FateNozomi/shichi-pcb/shichi.gerber/drill_config.png

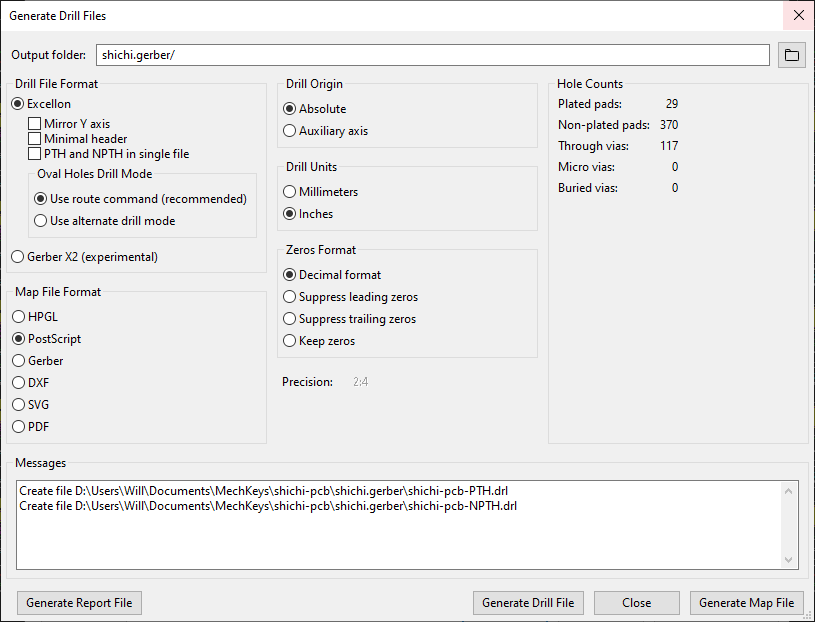
shichi.gerber/drill_config.png
