FateNozomi/shichi-pcb/shichi.gerber/plot_config.png

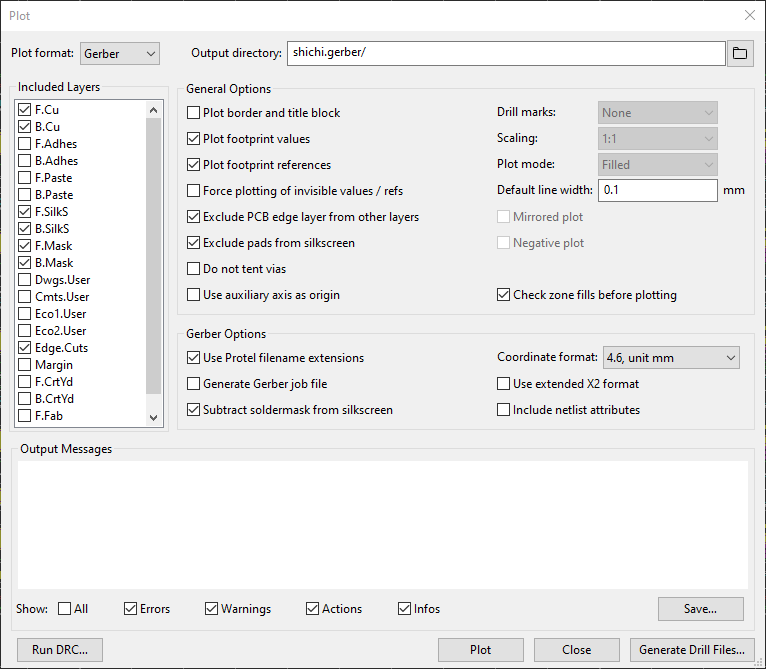
shichi.gerber/plot_config.png
