FateNozomi/shichi-pcb/shichi-pcb.kicad_pcb

## KiCad design shichi-pcb.kicad_pcb (2019-11-03)

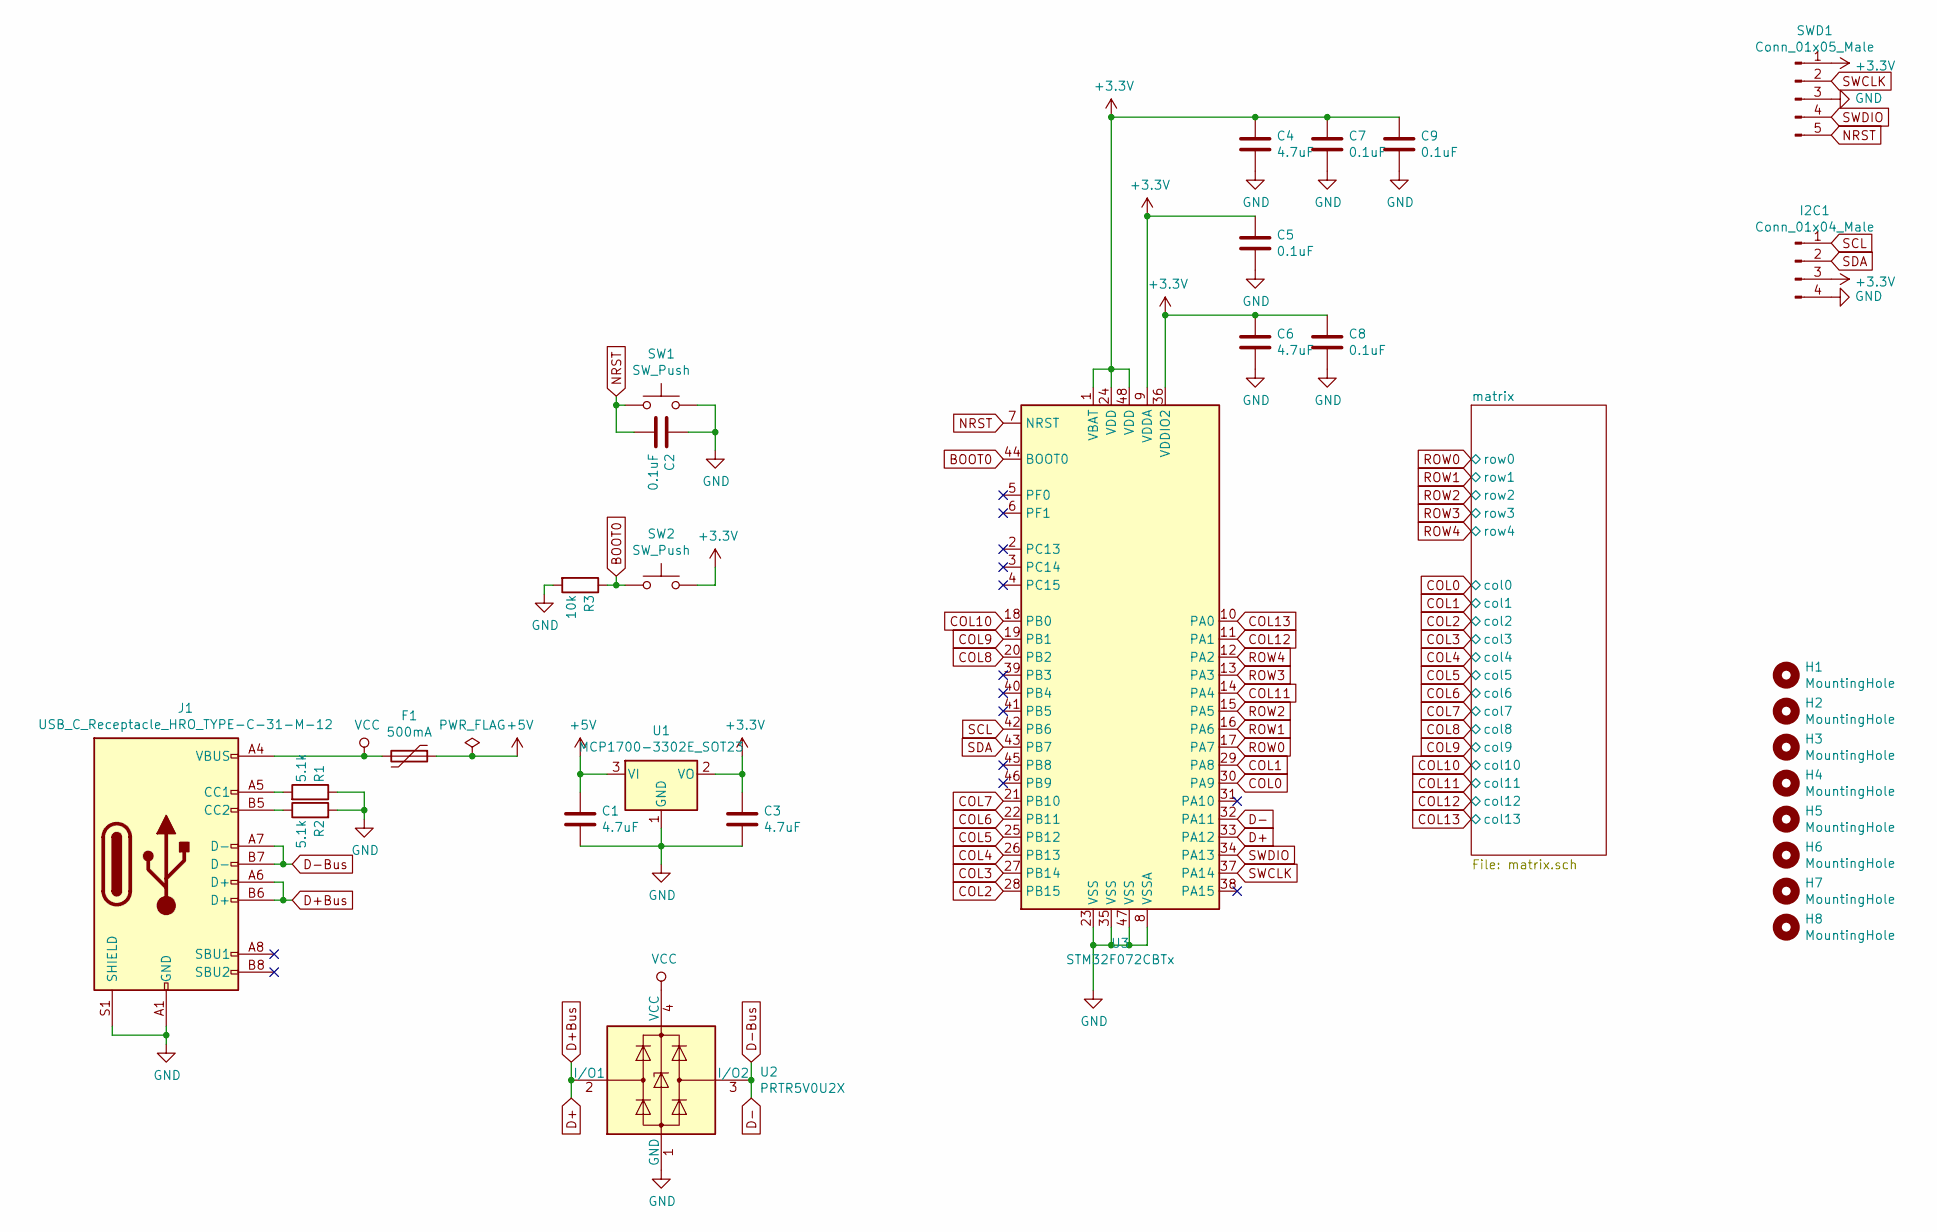
[picture p3: schematic shichi-pcb.sch, shichi]

Parts:
C1, C3, C4, C6: 4.7uF; C_0805_2012Metric_Pad1.15x1.40mm_HandSolder
C2, C5, C7, C8, C9: 0.1uF; C_0805_2012Metric_Pad1.15x1.40mm_HandSolder
F1: 500mA; Fuse_1206_3216Metric_Pad1.42x1.75mm_HandSolder
H1, H2, H3, H4, H5, H6, H7, H8: MountingHole; MountingHole_2.2mm_M2_Pad
I2C1: Conn_01x04_Male; I2C_Header_1x04_P2.54mm_Vertical
J1: USB_C_Receptacle_HRO_TYPE-C-31-M-12; USB_C_Receptacle_HRO_TYPE-C-31-M-12-HandSoldering
R1, R2: 5.1k; R_0805_2012Metric_Pad1.15x1.40mm_HandSolder
R3: 10k; R_0805_2012Metric_Pad1.15x1.40mm_HandSolder
SW1, SW2: SW_Push; SW_SPST_TL3342
SWD1: Conn_01x05_Male; SWD_Header_1x05_P2.54mm_Vertical
U1: MCP1700-3302E_SOT23; SOT-23
U2: PRTR5V0U2X; SOT-143
U3: STM32F072CBTx; LQFP-48_7x7mm_P0.5mm

Connections:
+3V3: C3.1, C4.1, C5.1, C6.1, C7.1, C8.1, C9.1, I2C1.3, SW2.2, SWD1.1, U1.2 (VO), U3.1 (VBAT), U3.9 (VDDA), U3.24 (VDD), U3.36 (VDDIO2), U3.48 (VDD); also elsewhere on the board
+5V: C1.1, F1.1, U1.3 (VI)
BOOT0: R3.1, SW2.1, U3.44 (BOOT0); also elsewhere on the board
COL0: U3.30 (PA9); also elsewhere on the board
COL1: U3.29 (PA8); also elsewhere on the board
COL2: U3.28 (PB15); also elsewhere on the board
COL3: U3.27 (PB14); also elsewhere on the board
COL4: U3.26 (PB13); also elsewhere on the board
COL5: U3.25 (PB12); also elsewhere on the board
COL6: U3.22 (PB11); also elsewhere on the board
COL7: U3.21 (PB10); also elsewhere on the board
COL8: U3.20 (PB2); also elsewhere on the board
COL9: U3.19 (PB1); also elsewhere on the board
COL10: U3.18 (PB0); also elsewhere on the board
COL11: U3.14 (PA4); also elsewhere on the board
COL12: U3.11 (PA1); also elsewhere on the board
COL13: U3.10 (PA0); also elsewhere on the board
D+: J1.A6 (D+), J1.B6 (D+), U2.2 (I/O1), U3.33 (PA12)
D-: J1.A7 (D-), J1.B7 (D-), U2.3 (I/O2), U3.32 (PA11)
GND: C1.2, C2.1, C3.2, C4.2, C5.2, C6.2, C7.2, C8.2, C9.2, I2C1.4, J1.A1 (GND), J1.A12 (GND), J1.S1 (SHIELD), R1.1, R2.2, R3.2, SW1.2, SWD1.3, U1.1 (GND), U2.1 (GND), U3.8 (VSSA), U3.23 (VSS), U3.35 (VSS), U3.47 (VSS); also elsewhere on the board
NRST: C2.2, SW1.1, SWD1.5, U3.7 (NRST); also elsewhere on the board
unnamed: J1.A5 (CC1), R1.2
unnamed: J1.B5 (CC2), R2.1
ROW0: U3.17 (PA7); also elsewhere on the board
ROW1: U3.16 (PA6); also elsewhere on the board
ROW2: U3.15 (PA5); also elsewhere on the board
ROW3: U3.13 (PA3); also elsewhere on the board
ROW4: U3.12 (PA2); also elsewhere on the board
SCL: I2C1.1, U3.42 (PB6)
SDA: I2C1.2, U3.43 (PB7)
SWCLK: SWD1.2, U3.37 (PA14)
SWDIO: SWD1.4, U3.34 (PA13)
VCC: F1.2, J1.A4 (VBUS), J1.A9 (VBUS), U2.4 (VCC)

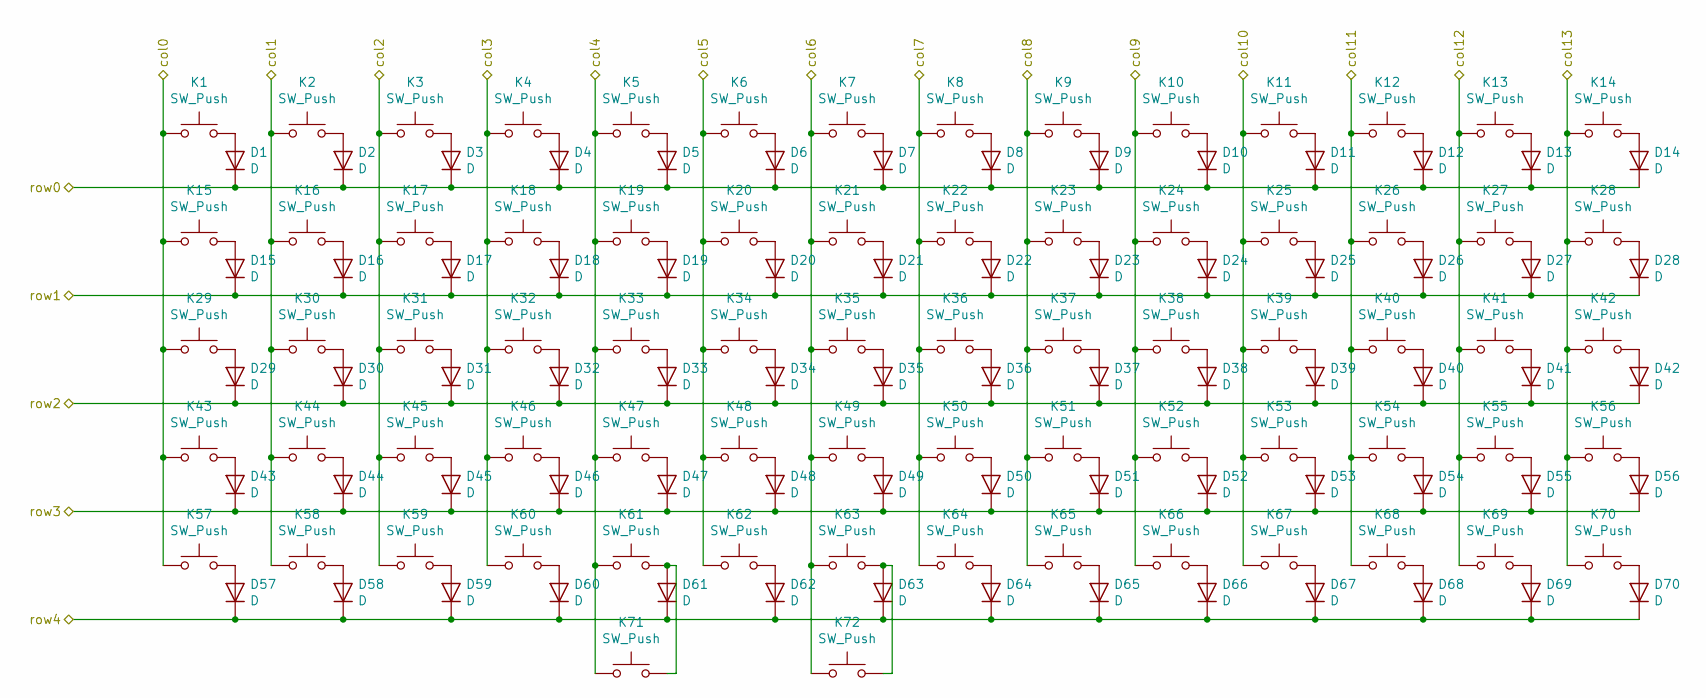
[picture p4: schematic matrix.sch]

Parts:
D1, D2, D3, D4, D5, D6, D7, D8, D9, D10, D11, D12, D13, D14, D15, D16, D17, D18, D19, D20, D21, D22, D23, D24, D25, D26, D27, D28, D29, D30, D31, D32, D33, D34, D35, D36, D37, D38, D39, D40, D41, D42, D43, D44, D45, D46, D47, D48, D49, D50, D51, D52, D53, D54, D55, D56, D57, D58, D59, D60, D61, D62, D63, D64, D65, D66, D67, D68, D69, D70: D; D_SOD-123
K1, K2, K3, K4, K5, K6, K7, K8, K9, K10, K11, K12, K13, K14, K15, K16, K17, K18, K19, K20, K21, K22, K23, K24, K25, K26, K27, K28, K29, K30, K31, K32, K33, K34, K35, K36, K37, K38, K39, K40, K41, K42, K43, K44, K45, K46, K47, K48, K49, K50, K51, K52, K53, K54, K55, K56, K57, K58, K59, K60, K61, K63, K64, K65, K66, K67, K68, K69, K70: SW_Push; MX_1.00u_PCB
K62: SW_Push; MX_7.00u_PCB_ReversedStabilizers
K71, K72: SW_Push; MX_2.00u_PCB_ReversedStabilizers

Connections:
COL0: K1.1, K15.1, K29.1, K43.1, K57.1; also elsewhere on the board
COL1: K2.1, K16.1, K30.1, K44.1, K58.1; also elsewhere on the board
COL2: K3.1, K17.1, K31.1, K45.1, K59.1; also elsewhere on the board
COL3: K4.1, K18.1, K32.1, K46.1, K60.1; also elsewhere on the board
COL4: K5.1, K19.1, K33.1, K47.1, K61.1, K71.1; also elsewhere on the board
COL5: K6.1, K20.1, K34.1, K48.1, K62.1; also elsewhere on the board
COL6: K7.1, K21.1, K35.1, K49.1, K63.1, K72.1; also elsewhere on the board
COL7: K8.1, K22.1, K36.1, K50.1, K64.1; also elsewhere on the board
COL8: K9.1, K23.1, K37.1, K51.1, K65.1; also elsewhere on the board
COL9: K10.1, K24.1, K38.1, K52.1, K66.1; also elsewhere on the board
COL10: K11.1, K25.1, K39.1, K53.1, K67.1; also elsewhere on the board
COL11: K12.1, K26.1, K40.1, K54.1, K68.1; also elsewhere on the board
COL12: K13.1, K27.1, K41.1, K55.1, K69.1; also elsewhere on the board
COL13: K14.1, K28.1, K42.1, K56.1, K70.1; also elsewhere on the board
unnamed: D1.2 (A), K1.2
unnamed: D2.2 (A), K2.2
unnamed: D3.2 (A), K3.2
unnamed: D4.2 (A), K4.2
unnamed: D5.2 (A), K5.2
unnamed: D6.2 (A), K6.2
unnamed: D7.2 (A), K7.2
unnamed: D8.2 (A), K8.2
unnamed: D9.2 (A), K9.2
unnamed: D10.2 (A), K10.2
unnamed: D11.2 (A), K11.2
unnamed: D12.2 (A), K12.2
unnamed: D13.2 (A), K13.2
unnamed: D14.2 (A), K14.2
unnamed: D15.2 (A), K15.2
unnamed: D16.2 (A), K16.2
unnamed: D17.2 (A), K17.2
unnamed: D18.2 (A), K18.2
unnamed: D19.2 (A), K19.2
unnamed: D20.2 (A), K20.2
unnamed: D21.2 (A), K21.2
unnamed: D22.2 (A), K22.2
unnamed: D23.2 (A), K23.2
unnamed: D24.2 (A), K24.2
unnamed: D25.2 (A), K25.2
unnamed: D26.2 (A), K26.2
unnamed: D27.2 (A), K27.2
unnamed: D28.2 (A), K28.2
unnamed: D29.2 (A), K29.2
unnamed: D30.2 (A), K30.2
unnamed: D31.2 (A), K31.2
unnamed: D32.2 (A), K32.2
unnamed: D33.2 (A), K33.2
unnamed: D34.2 (A), K34.2
unnamed: D35.2 (A), K35.2
unnamed: D36.2 (A), K36.2
unnamed: D37.2 (A), K37.2
unnamed: D38.2 (A), K38.2
unnamed: D39.2 (A), K39.2
unnamed: D40.2 (A), K40.2
unnamed: D41.2 (A), K41.2
unnamed: D42.2 (A), K42.2
unnamed: D43.2 (A), K43.2
unnamed: D44.2 (A), K44.2
unnamed: D45.2 (A), K45.2
unnamed: D46.2 (A), K46.2
unnamed: D47.2 (A), K47.2
unnamed: D48.2 (A), K48.2
unnamed: D49.2 (A), K49.2
unnamed: D50.2 (A), K50.2
unnamed: D51.2 (A), K51.2
unnamed: D52.2 (A), K52.2
unnamed: D53.2 (A), K53.2
unnamed: D54.2 (A), K54.2
unnamed: D55.2 (A), K55.2
unnamed: D56.2 (A), K56.2
unnamed: D57.2 (A), K57.2
unnamed: D58.2 (A), K58.2
unnamed: D59.2 (A), K59.2
unnamed: D60.2 (A), K60.2
unnamed: D61.2 (A), K61.2, K71.2
unnamed: D62.2 (A), K62.2
unnamed: D63.2 (A), K63.2, K72.2
unnamed: D64.2 (A), K64.2
unnamed: D65.2 (A), K65.2
unnamed: D66.2 (A), K66.2
unnamed: D67.2 (A), K67.2
unnamed: D68.2 (A), K68.2
unnamed: D69.2 (A), K69.2
unnamed: D70.2 (A), K70.2
ROW0: D1.1 (K), D2.1 (K), D3.1 (K), D4.1 (K), D5.1 (K), D6.1 (K), D7.1 (K), D8.1 (K), D9.1 (K), D10.1 (K), D11.1 (K), D12.1 (K), D13.1 (K), D14.1 (K); also elsewhere on the board
ROW1: D15.1 (K), D16.1 (K), D17.1 (K), D18.1 (K), D19.1 (K), D20.1 (K), D21.1 (K), D22.1 (K), D23.1 (K), D24.1 (K), D25.1 (K), D26.1 (K), D27.1 (K), D28.1 (K); also elsewhere on the board
ROW2: D29.1 (K), D30.1 (K), D31.1 (K), D32.1 (K), D33.1 (K), D34.1 (K), D35.1 (K), D36.1 (K), D37.1 (K), D38.1 (K), D39.1 (K), D40.1 (K), D41.1 (K), D42.1 (K); also elsewhere on the board
ROW3: D43.1 (K), D44.1 (K), D45.1 (K), D46.1 (K), D47.1 (K), D48.1 (K), D49.1 (K), D50.1 (K), D51.1 (K), D52.1 (K), D53.1 (K), D54.1 (K), D55.1 (K), D56.1 (K); also elsewhere on the board
ROW4: D57.1 (K), D58.1 (K), D59.1 (K), D60.1 (K), D61.1 (K), D62.1 (K), D63.1 (K), D64.1 (K), D65.1 (K), D66.1 (K), D67.1 (K), D68.1 (K), D69.1 (K), D70.1 (K); also elsewhere on the board

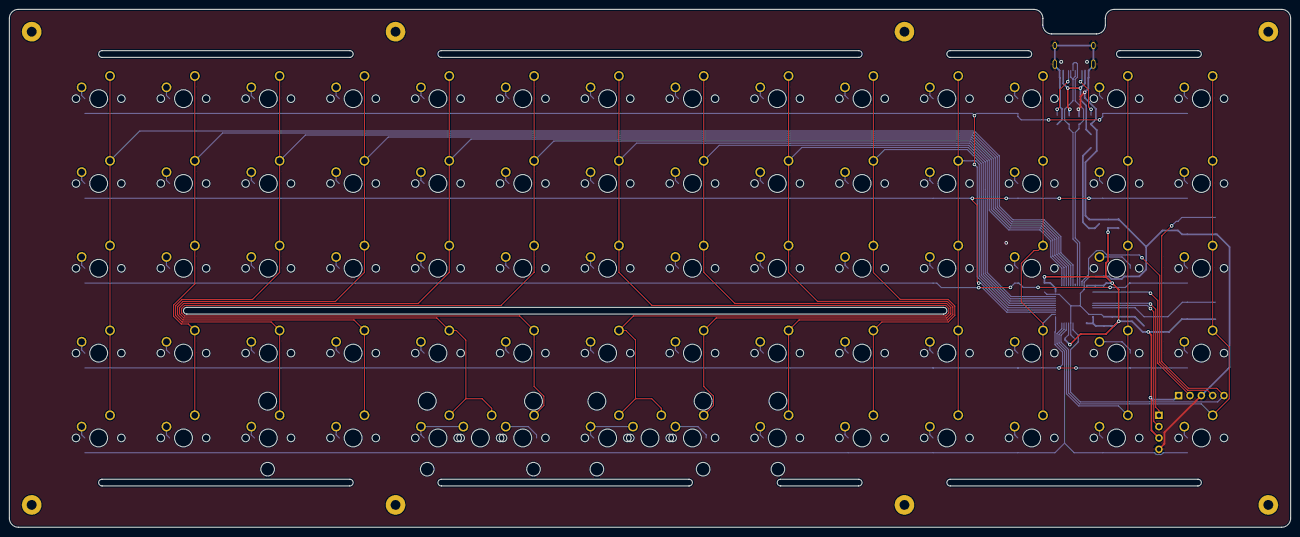
[picture p5: board shichi-pcb.kicad_pcb from above]

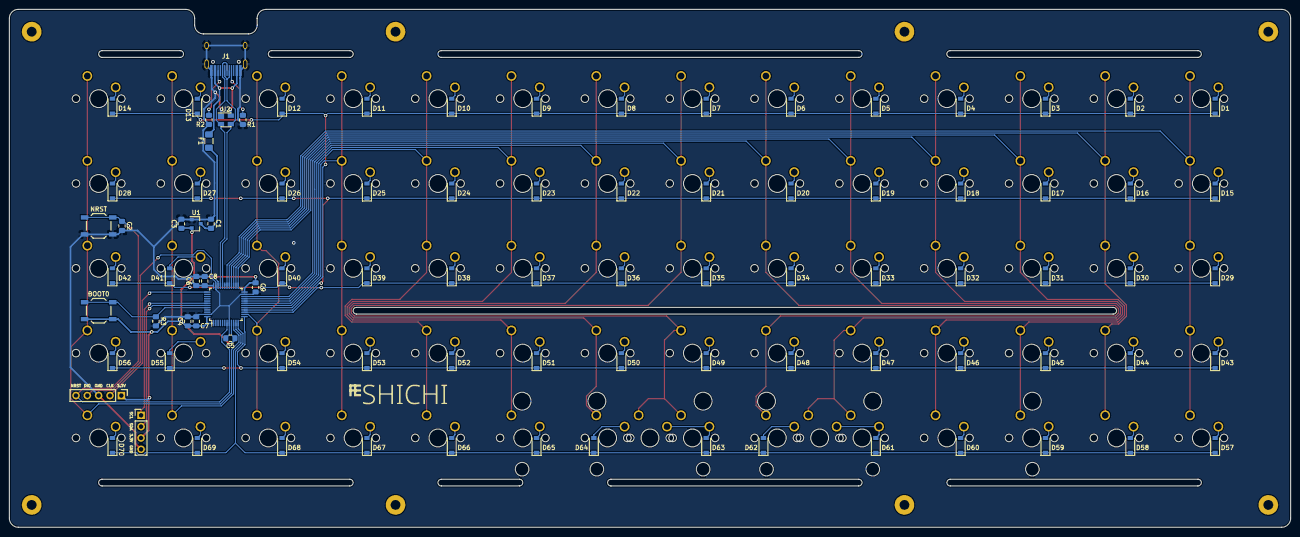
[picture p6: board shichi-pcb.kicad_pcb from below]

Board: 2 copper layers, 287.0 x 116.0 mm, 171 parts (91 on the bottom side), 103 nets.

Other parts of the board:
BOOT0: SW_Push; SW_SPST_TL3342
NRST: SW_Push; SW_SPST_TL3342

Their connections:
+3V3: BOOT0.2; also elsewhere on the board
BOOT0: BOOT0.1; also elsewhere on the board
GND: NRST.2; also elsewhere on the board
NRST: NRST.1; also elsewhere on the board
