FateNozomi/shichi-pcb/(commit log)

2019-06-07 Assign PCB footprints to schematic symbols
    [matrix.sch, shichi-pcb.sch]
2019-06-07 Use custom symbol for USB C Receptacle USB C Receptacle from 5.1.2 symbol library VBUS and GND are set to power input instead of power output
    [shichi-pcb.sch]
2019-06-07 Fix XTAL1 ground short
    [shichi-pcb.sch]
2019-06-08 Use vertical group headers instead of individual headers
    [shichi-pcb.sch]
2019-06-08 Ground XTAL capacitors
    [shichi-pcb.sch]
2019-06-09 Optimize matrix pinout
    [shichi-pcb.sch]
2019-06-11 Add breakouts for unused pins
    [shichi-pcb.sch]
2019-06-12 Initial PCB layout design
    [shichi-pcb.kicad_pcb]
2019-06-12 Implement over-current protection using polyfuse
    [shichi-pcb.sch]
2019-06-12 Add polyfuse to PCB layout design
    [shichi-pcb.kicad_pcb]
2019-06-29 Make ESD protection component mandatory in schematic
    [shichi-pcb.sch]
2019-06-29 Update PCB layout tracks for ESD Protection
    [shichi-pcb.kicad_pcb]
2019-06-30 Initial port of STM32F072 arm processor
    [shichi-pcb.sch]
2019-06-30 Assign PCB Footprints to new additional schematics
    [shichi-pcb.sch]
2019-07-05 Remove 22 ohm resistors from data lines
    Stated in the STM32F072CB datasheet P.99:
    No external termination series resistors are required on USB_DP (D+) and USB_DM (D-);
    the matching impedance is already included in the embedded driver.
    [shichi-pcb.sch]
2019-07-05 Replace MCP1825S with MCP1700-3302E LDO voltage regulator
    [shichi-pcb.sch]
2019-07-05 Optimize STM32F072 matrix pinout
    [shichi-pcb.sch]
2019-07-05 Flip serial wire debugging header pins
    [shichi-pcb.sch]
2019-07-06 Swap ROW3 and ROW4 pins to reposition diode D50
    [shichi-pcb.sch]
2019-07-07 Initial arm PCB layout design
    [shichi-pcb.kicad_pcb]
2019-07-07 Remove NRST pull-up resistor
    The NRST pin input driver uses the CMOS technology. It is connected to a permanent pullup resistor, RPU
    [shichi-pcb.kicad_pcb, shichi-pcb.sch]
2019-07-07 Add mounting holes
    [shichi-pcb.kicad_pcb, shichi-pcb.sch]
2019-07-07 Add NRST and BOOT0 switch labels on B.SilkS
    [shichi-pcb.kicad_pcb]
2019-07-07 Add GND filled zone on F.CU and B.Cu
    [shichi-pcb.kicad_pcb]
2019-07-07 Remove mounting hole references on F.SilkS
    [shichi-pcb.kicad_pcb]
2019-07-07 Plot v1.0 gerber files for fabrication
    [shichi-pcb-B_Cu.gbl, shichi-pcb-B_Mask.gbs, shichi-pcb-B_SilkS.gbo, shichi-pcb-Edge_Cuts.gm1, shichi-pcb-F_Cu.gtl, shichi-pcb-F_Mask.gts, shichi-pcb-F_SilkS.gto, shichi-pcb-NPTH.drl]
2019-07-12 Remove unused pin labels on silk screen layer
    [shichi-pcb.kicad_pcb]
2019-07-22 Fix D+ and D- label swapped
    [shichi-pcb.kicad_pcb]
2019-07-22 Increase ground copper zone clearance
    [shichi-pcb.kicad_pcb]
2019-10-19 Plot v1.1 gerber files for fabrication
    [shichi-pcb-B_Cu.gbl, shichi-pcb-B_Mask.gbs, shichi-pcb-B_SilkS.gbo, shichi-pcb-Edge_Cuts.gm1, shichi-pcb-F_Cu.gtl, shichi-pcb-F_Mask.gts, shichi-pcb-F_SilkS.gto, shichi-pcb-NPTH.drl]
2019-10-20 Remove USB headers
    [matrix.sch, shichi-pcb.kicad_pcb, shichi-pcb.sch]
2019-10-20 Remove B14 and B15 pin headers
    [shichi-pcb.kicad_pcb, shichi-pcb.sch]
2019-10-20 Remove AUDIO components
    [shichi-pcb.kicad_pcb, shichi-pcb.sch]
2019-10-20 Replace all MX switch footprint to through-hole solder variant
    [matrix.sch]
2019-10-20 Change bottom row to support 6.25u spacebar
    [matrix.sch]
2019-10-20 Change USBLC6-2SC6 ESD protection device to PRTR5V0U2AX
    [shichi-pcb.sch]
2019-10-21 Replace 6.25u with 7.00u spacebar support
    [matrix.sch]
2019-11-03 Update PCB layout design to v2
    [shichi-pcb.kicad_pcb]
2019-11-03 Reposition diode reference text
    [shichi-pcb.kicad_pcb]
2019-11-03 Add shichi logo
    [shichi-pcb.kicad_pcb]
2019-11-03 Plot v2.0 gerber files for fabrication
    [shichi-pcb-B_Cu.gbl, shichi-pcb-B_Mask.gbs, shichi-pcb-B_SilkS.gbo, shichi-pcb-Edge_Cuts.gm1, shichi-pcb-F_Cu.gtl, shichi-pcb-F_Mask.gts, shichi-pcb-F_SilkS.gto, shichi-pcb-NPTH.drl]
